Cailynoo7/makit-project-4/product/README.md

# 收音机外型静音漏接提醒器

面向中老年人的随身蓝牙挂件，由子女协助首次设置。优先支持 Android，降低手机静音或勿扰造成连续漏接的重要电话风险。

## 用户要求

保持低功耗蓝牙连接；10 分钟滑动窗口内连续 3 通来电均未接听，且处于静音/勿扰时触发。静音状态不可读时允许使用疑似静音模型。提示音可切换“叮咚叮咚”和“叮叮叮叮”，明显但不惊吓。查看手机、按前面单键停止提醒、接听或回拨后停止。22:00–06:00 默认无声。

后面是中心同高横排的Type-C充电口和ON/OFF开关机按键（电源键中心x7,z9），前面仅保留一个黑色底、红色三角标识的换音多功能键，位于原下方位置；上方圆形装饰略上移（默认1.5mm），顶部音量加减。严格参照上传图的黑色收音机外形，保留加粗圆角矩形提手，顶部正中设封闭半圆形穿绳孔、双圆网罩银色圈、长条调谐窗、中部方键与红色点缀。整体最长边不超过 60 mm。先完成硬件选择，再设计外壳。

## 手机侧可行性与待决事项

用户已选择轻量 Android 配套 App，由子女安装并首次授权，老人日常只使用挂件。应用负责电话状态、通知及铃声/勿扰状态读取、事件判定和 BLE 指令；挂件负责声音、按键、时间静音与连接状态。Android 伴侣设备授权不能替代电话/通知权限。

来电 RINGING→IDLE 不能独自区分未接与主动拒接；通知可能合并、多卡/来电等待可能造成歧义，不能将一条通知更新计作一通电话。默认结合电话状态与系统未接通知去重，不能辨认时不假装已确认。通知删除也不必然代表用户查看。实机未测试，不承诺跨品牌兼容。

## 平台候选与下游任务

主控默认选用 Seeed Studio XIAO nRF52840 Series（索引 seeed/xiao-ble，基础版，非 Sense/Plus）。厂商资料给出 21 × 17.8 mm、BLE 与 BQ25101 充电管理，适合小型低功耗挂件。选择理由为体积较小，厂商针对 BLE/低功耗提供支持，适合连续连接挂件；连接功耗仍须实测。

比较候选 M5Stack Atom Voice（m5stack/atomecho）：集成扬声器、24 × 24 × 16.8 mm，但较厚；厂商提供的 A2DP 示例不支持电话，本身不解决来电状态读取。Grove Speaker/Plus（seeed/grove-speaker、seeed/grove-speaker-plus）已检索，发声模块尺寸、电源和布置待核对。候选不构成采购清单或已验证装配。

硬件阶段由设计助手落实电池、音频驱动/扬声器、按键及供电，取得机械包络、充电口与装配证据后完成接线及零件清单。用户已选择设计小载板整理四个按键及音频、电源外围，保留 XIAO 主控，并接受制板费用与等待。CAD 在硬件和接线具备依据后开始。软件实施与实机兼容测试另需手机与固件开发环境，本文及外壳交付不代表功能样机已运行。

## 已披露默认值

- 60 mm 包含提手、按键和固定挂点，可拆挂绳除外；已按硬件定为总厚度目标约19mm，包含按键与固定突出部。单张参考图没有背面尺寸，背部按功能工程设计。
- 首版仅系统蜂窝来电，跨号码计数，接听成功或确认清空序列；拒接不计入疑似漏接。按第 3 通结束未接判定。
- 无法读取静音时，以连续未接且无成功接听/确认为启发式；不得宣称可证明静音。
- 前面原下方位置的三角标识单键：待机短按换音并试听，提醒中短按只停止本轮并清零，长按3秒开放60秒配对；后键长按 2 秒开关机。调谐窗为装饰，双网罩可由单扬声器出声。
- 仅解锁/亮屏不等于看过未接电话；点击未接通知或明确确认可作为查看证据，不能检测时在提醒中短按前面单键停止本轮，不能据此认定已查看手机。
- 提示每 10 秒一次、渐强起音、单轮至多 2 分钟，之后保留无声状态。3 档音量，最大档目标为 0.5 米处 65–75 dBA，须试听及实测。
- 手机同步本地时间；无有效时间则保持无声提示需连接。夜间不出声，06:00 不集中补响。
- 连续连接待机目标 72 小时、每日 10 次短提示，容量和实际续航在硬件阶段落实并实测。
- 断连不判漏接、不补报旧电话；重连去重。低电、断连用低亮状态灯提示。首版本地处理，不上传通话记录，BLE 不传号码。

## 验收

用时间戳序列验证 600 秒内第三通未接后触发，两通不触发、超窗不触发、接听后重计、拒接不误计、通知更新不重复。验证普通响铃时不误响，状态不可读走明确标注的疑似路径。验证两种提示音、三级音量、提醒中前面单键停止、已查看/接听/回拨停止，以及 22:00、06:00 边界、重启无时钟和断连重连。检查背部/前部/顶部操作位置；参考图可见元素保留；所有固定突出部在 60 mm 包络内。依据厂商机械资料检查硬件装配、充电插头空间及发声通道，最终交付 STEP。功能与功耗须样机测量，当前交付硬件设计与外壳模型，Android App及固件交付为待真机联调的软件验证版。

## 研究依据

- Android 来电状态监听：https://developer.android.com/reference/android/telephony/TelephonyCallback.CallStateListener
- Android 通知读取及勿扰状态：https://developer.android.com/reference/android/service/notification/NotificationListenerService
- 铃声模式：https://developer.android.com/reference/android/media/AudioManager#getRingerMode()
- Android 未接通知分类：https://developer.android.com/reference/android/app/Notification#CATEGORY_MISSED_CALL
- BLE 后台通信：https://developer.android.com/develop/connectivity/bluetooth/ble/background
- 伴侣配对仍需应用建立连接：https://developer.android.com/develop/connectivity/bluetooth/companion-device-pairing
- XIAO 厂商文档：https://wiki.seeedstudio.com/XIAO_BLE/
- Atom Voice 厂商文档：https://docs.m5stack.com/en/atom/atomecho

## 小载板与电池选择

用户选择小载板替代四键及外围手工飞线，授权载板设计；尚未制作电路板。主控仍是XIAO nRF52840。用户允许目录外电池，要求国内淘宝等平台可购买。

两个不同厂家候选有国内立创商城现货记录：

- 远阳 FLY.502728.390，C5154896，390 mAh。规格书第12页带PCM成品最大30.5×28×5.3 mm，线长33±5 mm；第5页充电4.2 V、标准78 mA、最大390 mA、最大放电390 mA、放电截止3.0 V。第4页裸电芯不能替代第12页成品。https://item.szlcsc.com/5783013.html ，2026-11-09查询11件。用户已选择；容量较大、较薄但较宽。
- 康胜 602030-300mAh-3.7V，C3036734，300 mAh。规格书第4页明确带PCM出线成品，最大33×20.5×6.5 mm，线长40±5 mm；第5页标准60 mA充电、4.2 V、连续放电300 mA、充电10–45℃。最大充电电流栏为空，不自行视为允许更高电流。https://item.szlcsc.com/3588019.html ，2026-11-09查询26件。较窄但较厚。

规格书已下载并检查机械图。保护板过流阈值不是电芯允许工作电流，额定容量不能直接承诺72小时待机。候选库存为公开查询快照。

另比较VCELL VP402030，200 mAh，带保护尺寸最大32.5×20.5×4.2 mm，4.2 V充电，标准40 mA、最大200 mA。厂商仅提供询价入口，未核实零售现货，故不优先：https://www.vcellpower-battery.com/zh_cn/3.7v/3-7v-200mah-402030-small-rechargeable-lipo-battery.html 。台思科402030-200mah C19632335在立创查询无现货。淘宝通用402030存在检索线索，但没有与上述精确厂家/带保护版本对应的直接证据，不承诺淘宝同型号现货。

用户已选远阳FLY.502728.390带PCM成品；康胜仅作机械不兼容的备选，不能直接换型。发声选用PAM8302AASCR及华龙HDK-1804AA-1W（18 mm、4Ω、额定0.8 W），已检查功放应用电路与扬声器机械图，音量未实测。前面多功能换音键及背面电源键选TS-1187A-B-A-B共2颗，顶部两键采用用户授权改选的侧按SHOU HAN TS24CA（C393942）。Grove Speaker要求4.0–5.5 V，不能直接覆盖单节锂电整个电压范围，未采用。设计助手在电池选定后落实充电、电源、连接及布局，再进行PCB与CAD。

载板规格52×26×1mm双层，采用供应商精确封装。外壳保持参考图提手、双圆网罩、银圈、调谐窗与中央方键/红点，整体目标60×48.4×约19mm。后盖2颗M2×6沉头螺钉可拆，前1、顶2、后1四键位置分面保持要求；默认PETG打样，薄装饰采用印刷/裁切薄膜。
## 薄型装配要求

整机总厚度约19mm，保留XIAO nRF52840基础版、390mAh带PCM电池、顶部音量键及后置Type-C。主控与电池在后部并排，前部扬声器及载板；默认取消高排针，改用低矮焊接短线。后置Type-C为载板垂直插座，连接XIAO的5V/GND，保留原板充电路径；只作充电，不提供后口USB数据。XIAO原USB保留在壳内，编程时拆盖。

外壳圆角适度加大，左右侧过渡连续对称；默认外轮廓四角R1.6mm、前缘R1.2mm、后缘R0.6mm。两侧内部加强条外缘内收0.35mm并遵循圆角轮廓，避免补出局部直边。

后盖要求外缘齐平、闭合贴合，避免明显大缝隙。默认内藏搭接与0.15mm接合面间隙，搭接方向侧向/轴向各留0.2mm装配余量；实际贴合需打印首件验证。

后盖固定采用左右对称沉头螺钉与内藏挂钩结构：下缘两个内藏挂钩，上缘保留2颗M2×6螺钉，拧紧后头部与后盖齐平，不加遮孔片，仅保留匹配沉头的小孔；整机厚度19.05mm，外缘齐平、名义细缝0.15mm，主控、电池、载板、四键及后置Type-C保持现有配置。

提手与前壳一体：默认条宽3.4mm、深3.6mm，外上角R2.0mm、内上角R1.4mm、前后边缘R0.45mm。中央圆拱内的半圆穿绳孔默认宽4mm、高2mm，用于细挂绳绳环；固定圆拱计入整机尺寸，总高约48.4mm，最长边仍60mm。穿绳与提手承载需首件验证。
