Cailynoo7/makit-project-4/design/radio-reminder/README.md

# 约19mm薄型收音机提醒器
中老年人随身挂件。保留黑色参考图收音机：60mm宽、48.4mm含提手/穿绳圆拱高，银色双圆圈与调谐窗、中央黑色方键、红色三角顶面和红点。整机含全部固定突出部60×48.4×19.05mm，机身60×34×17.5mm；约为厚版的一半。正面-Y、背面+Y、顶部+Z。顶部加减仍x=-18/-7，前面仅一个三角标识换音键，移至原下方中心x0,z-4；上方旧开口封闭，红色圆点中心z3.1mm（上移1.5mm），银色饰线保持，充电口和电源键在背面上部中心同高横排。默认PETG黑色、银灰饰圈，少量红和米色印刷装饰。

## 硬件与接口
hardware_fit：载板当前发布bbae20a434339443ea3c5a5be6bef92bbbb1d6c7cf2214563fcd01bb77dd2b27，真实装配STEP，52×26×1mm，Rxyz=(90,0,0)、T=(-100,-0.3,100)。取消高排针，10根30AWG约50mm绝缘短线贴板平铺，焊点/线层高度≤0.8mm。
XIAO基础版板面平行前后壳，长轴X，原USB朝+X留在壳内。官方v1.2 KiCad/DXF外轮廓20.955×17.78mm；PCB中心(15.4,5.8,-3.5)，基板保留1mm，元件向前保留4mm，原USB最大保留至x27.386。高度为工程保留区，非实物量测；无可用官方STEP，不发布假主控实体。
后口GT-USB-7096C为8.5±0.2mm垂直插座，载板B面，中心x17.4,z9；后盖外侧收口9.54×3.76mm、R1.6，内侧11.8×5.4mm胶囊让位。实际口沿y9.135，突出壳面约0.385mm，整机最大后边界仍由电源帽y9.45限定。5V/GND接XIAO原充电路径，两路CC各5.1k下拉；后口只充电。原USB供拆盖编程，不同时接两口电源。
电池为用户选定FLY.502728.390带PCM，最大30.5×28×5.3mm，中心(-10.8,3.6,0)，后面0.5mm可移除泡棉贴后盖。XIAO与电池并排，间距0.4725mm。
扬声器HDK-1804AA-1W最大D18.2×4.8mm，中心(-18,-3.95,-5)，轴沿Y；左罩出声、右罩盲孔装饰。前加0.15mm黑色透声布；边缘胶固定。扬声器、电池和XIAO用临时最大包络查询，不以占位块冒充真实零件。
user_controls：前1顶2后1，顶部TS24CA C393942。换音单键中心x0,z-4；无独立确认键；音量加减x-18/-7、y-1.95；后电源x7,z9，与Type-C同高。radio_reference为用户原图。

## 检查
所有单独制造件均一实体；各已发布对象无共享实体体积。总包络X[-30,30]、Y[-9.6,9.45]、Z[-17,31.4]mm。
0.02mm网格：载板对壳最小0.155mm；电池对前壳0.25mm、对下挂钩0.2mm、对载板0.318mm；XIAO板对后盖0.2mm，元件保留区对载板0.21mm；原USB对侧壳0.214mm；扬声器最大包络对壳0.1916mm、对载板0.3mm。只是设计间隙，不是打印后实测公差。
先卸两颗齐平沉头螺钉；后盖/电源帽绕下缘(0,6.6,-17)沿X轴向后转7°，上移0.8mm，再后退20mm脱钩。0.1mm步长、0.02mm网格、265姿态对前壳/载板检查无穿插；线束、贴后盖的主控/电池维修余量需实装复核。
保留四键的0.3mm压下路径；单个前键已以0.1mm步长复核，旧顶键和后键几何保持，以0.1mm步长、0.02mm网格检查不撞壳；最小顶部0.1mm、正面0.25mm，电源按到底余0.05mm。该0.05mm为轴向止挡余量，头部径向滑动间隙0.25mm；首件应检查回弹并调整打印补偿。开关模型静止端与推杆约0.15mm间隙。

## Making and assembly
默认PETG、0.2mm喷嘴、0.1mm层高，至少4壁。正面壁2mm、侧/顶壁2.4mm；前壳面朝下，提手背面及内部悬臂有可拆支撑，功能滑道和螺钉孔避免残留。后盖外侧朝下、定位边朝上，支撑内部短悬臂；四键帽、银圈、调谐框/底片独立打印。可改韧性树脂打样，但先试拧螺钉、不强拧。
后盖由套件生成的2颗ISO7046 M2-0.4×6沉头螺钉连接、4mm自成形啮合，改为左右对称位置(-27.4,8.75,13.8)、(27.4,8.75,13.8)。套件采用boss=none，利用原侧壁局部加厚条锚固，不增加凸出的螺钉柱；不强拧。螺钉座使用90°沉头、head_recess=0，采用名义齐平沉头，套件的打印补偿使模型头顶低于盖面0.1mm，避免凸出，首件按真实螺钉试配齐平；删除遮孔片和Φ4.9大圆槽，仅保留套件按M2沉头头径生成的约Φ4.21mm沉孔。下缘x±18mm各有5mm宽、0.8mm厚刚性挂钩，先斜插再合盖，不依赖强行弹性卡入。后盖外缘与前壳同宽同高齐平；接合面各0.1mm去锐，名义接合面间隙0.15mm。侧壁及上缘内藏搭接从前壳末端伸出0.85mm、截面1.6mm，侧向及轴向各留0.2mm；Z<-10mm区域去掉搭接以便斜开，底边由挂钩压住。螺钉区让位，保持完整沉头承压区；搭接位于原侧壁厚度内，不侵入电池或原USB空间。调谐框用套件生成胶垫连接；银圈浅槽点柔性中性电子胶。U饰线、红点、红调谐线和2片米色表盘为印刷/裁切薄膜，不做FDM结构件。
先从内侧装前/顶部帽，再后装载板。定位轨前挡两边点胶，下缘后挡3×1mm、厚0.3mm泡棉。检查PCB平整、前按键无预压。XIAO元件面朝前，后面通过2条3×10mm、厚0.25mm薄胶贴在后盖固定面，并由下缘定位边定位。电池用2条0.5mm泡棉贴后盖内面，不加硬夹、不能压迫电芯。
按载板说明逐根焊接10线，保留约50mm长度及维修松弛量；余线在载板背面空区绝缘平铺，控制线层≤0.8mm，不在电池/主控之间叠成线团，不加金属胶带覆盖天线。电池TP1+/TP2-、扬声器TP3/TP4，BTL两端均不可接地。原线不足时用28AWG柔软线延长并热缩绝缘、胶点卸力。
电源帽从后盖内侧穿入，检查凸缘与导向孔滑动；新短推杆替代原长杆。合盖前先逐键确认回弹、Type-C居中及细壳插头可完全插入，先斜插下挂钩后压合上缘，再交替轻拧两颗螺钉至贴合。

## 首件验证边界
载板制作包已通过电气/间距及连通检查，另有4条非阻断丝印提示。外壳是计算装配检查通过的打样设计；需首件量测XIAO真实高度、按帽行程/回弹、线层、Type-C、拆盖余量和提手承载。XIAO天线邻近电池及载板，BLE范围和连接功耗需首样验证；不把装得下当作射频通过。App与固件为已编译、待真机联调的软件验证版；静音漏接、夜间、响度、续航、充电终止/温升和EMC未实测。XIAO充电TS为固定电阻，无电池实时测温。

后盖配合首件：去掉搭接槽与端面毛刺，先不放电子件轻压合盖，验证0.15mm接合间隙均匀、无翘曲，再装电子件。打印配合偏紧时先调整隐藏搭接侧隙，不强拧螺钉拉平。保留细缝供拆装，不宣称零缝或防水。前壳/后盖均为60×34mm外轮廓；0.02mm网格、0.1mm步长的后盖7°倾斜、0.8mm上提、20mm退出检查无穿插，单件各一实体，整机仍60×48.4×19.05mm。

隐藏固定首件：检查两个挂钩根部及边缘无支撑残留，验证螺钉顶面齐平；螺钉孔附近侧壁余肉约1mm，先验证低扭矩锁紧与反复拆装，挂钩保持力和跌落实测未完成。后盖两颗M2×6改为露出且齐平的沉头固定，下面仍为内藏挂钩；正面改为单键，载板已删除独立确认开关。

## 正面单键布局与功能
正面只保留原下方位置的方形三角标识换音键；删除圆形标识确认键和原上方开口，前壳恢复连续表面。键帽黑色，三角凸纹顶面红色，与红点同色调；键帽6.2mm、孔边每侧0.25mm间隙，按帽推杆对准载板SW_SOUND中心(0,-4)。待机短按换音试听，提醒中短按只停止本轮并清空计数，不记录为已查看手机；长按3秒开放60秒配对。载板删SW_ACK、TP8、ACK网络及XIAO D3线，连接改为10线。四键其余分布与19.05mm总厚度、0.15mm接缝及隐藏后盖固定保持。

## 背面布局
电源键上移到x7,z9，与Type-C中心z9对齐，保持原键帽、同一开关及D6功能。下方居中推杆会穿入电池最大包络，因而采用上方横排。两颗黑色M2×6采用名义齐平沉头，模型头顶低于盖面0.1mm，不增加遮孔片，不再挖独立大圆槽；名义接缝0.15mm和整体厚度19.05mm保持。

## 后口轮廓
采用内侧让位、外侧贴合收口的台阶结构。真实插座口沿位于y8.285附近，外轮廓约9.14×3.36mm；可见孔9.54×3.76mm、角R1.6，名义每边0.2mm余量。收口边y8.45至9.15，轴向0.7mm，高出背板0.4mm；与后盖一体，外边12.2×5.8mm胶囊，与主盖重叠连接。深处保留11.8×5.4mm胶囊孔清让插座本体。收口环对真实载板局部最小净距约0.2592mm，非零间隙配合；整机后界仍由电源帽y9.45限定。
收口边为精细非承力特征，保持0.2mm喷嘴、0.1mm层高；外表面有0.4mm凸起后，不能再将外侧平面直接贴打印床。后盖须外侧朝上，内侧凸台/挂钩用可拆支撑，或采用韧性树脂首件。支撑不得残留在接口孔、搭接及螺钉座。须实测插头肩部不顶收口、能完全插入及充电；名义每边0.2mm间隙需要打印校准，不承诺零缝或所有线缆兼容。

## 前面配色与圆点位置
三角标识使用红色#c22b43，基底黑色#202124。三角仍为键帽原有凸纹，顶面名义0.05mm为红色丙烯酸涂层，替代同体积黑色材料，总凸起高度0.25mm保持。模型中的sound_triangle为涂装区域，不是另一个按键或需要单独装配的零件；单色打印黑色键帽后以细笔给凸纹顶面上红色，固化后检查不蹭色，避免漆进入导向间隙。不要把0.05mm涂层单独作为FDM打印件。
上方圆形装饰仍直径2.9mm、中心x0，中心z由1.6mm上移至3.1mm。1.5mm为默认上移量，可通过圆点中心高度参数调整；没有新增前壳开孔或电气器件。

## 提手与挂绳孔
提手与前壳一体，保留58mm外宽和主框10mm出高；横梁、两侧的名义条宽均3.4mm，前后深3.6mm。外上角R2mm、内上角R1.4mm，前后轮廓边缘R0.45mm，减少原先薄直梁的生硬感。顶部中央有半圆外形的整体圆拱（外半径4.4mm），根部R0.6mm过渡；圆拱内为封闭D形半圆穿绳孔，名义宽4mm、高2mm，平底z27.2、轴沿前后Y。孔口前后也R0.45mm去锐，避免尖锐孔沿磨绳。
圆拱顶z31.4mm，整机总高48.4mm，最长边仍60mm，总厚度19.05mm。孔圈承力中段顶部名义厚度约2.2mm，前后圆角后的孔口薄缘需首件复核，须首件检查实际壁厚、打印层间完整性及挂绳反复拉扯；不宣称通过承载或跌落测试。适配细软绳环，不默认金属钥匙圈或粗编织绳均可穿过。保持PETG至少4壁，提手及圆拱整体打印；孔内支撑和毛刺需彻底去除。

穿绳孔空间检查：两股直径1.2mm、中心x±0.75mm/z28.05mm的直线绳段沿Y贯穿查询，与壳体无穿插；半圆孔位不变，圆拱加厚只向孔外扩展。0.02mm网格下原轮廓查询最小间隙0.25mm；仅验证几何穿过，不代表实际软绳摩擦/打结或承载已验证。

## 外壳圆角与侧边连续性
前后壳共用外轮廓四角R1.6mm，前面外缘R1.2mm、后盖外缘R0.6mm；接合边R0.1mm及名义0.15mm接缝保持。左右内部螺钉加强条外缘内收0.35mm，并按相同R1.6外轮廓裁切，避免加强条补平外圆角、在左右侧形成不连续直边。加强条原内边界保持，硬件位置不变。
本版解析几何检查：加强条区域超出共用圆角轮廓的体积为0，左右外侧接缝突起探针体积均为0，前壳为单一实体。左右侧视及前后斜视复核过渡连续。后盖/电源帽按7°倾斜、0.8mm上提、20mm退出路径复核无穿插，步长0.1mm、网格公差0.02mm、265姿态。外形60×48.4×19.05mm保持；打印后的接缝均匀度、沉头强度及拆装仍需首件验证。
