Cailynoo7/makit-project-4/manufacturing/reminder-carrier/releases/bbae20a434339443ea3c5a5be6bef92bbbb1d6c7cf2214563fcd01bb77dd2b27/package/drill/reminder-carrier-drill-report.txt

Drill report for board.kicad_pcb
Created on 2026-11-09T09:46:59

Copper Layer Stackup:
    =============================================================
    L1 :  F.Cu                      front
    L2 :  B.Cu                      back

Drill file 'board-PTH.drl' contains
    plated through holes:
    =============================================================
    T1  0.300mm  0.0118"  (7 holes))
    T2  0.800mm  0.0315"  (4 holes)  (with 4 slots)
    T3  1.000mm  0.0394"  (12 holes))

    Total plated holes count 23

Drill file 'board-NPTH.drl' contains
    unplated through holes:
    =============================================================
    T1  0.600mm  0.0236"  (2 holes))
    T2  0.700mm  0.0276"  (4 holes))

    Total unplated holes count 6
