Cailynoo7/makit-project-4/product/gallery/cover.jpg

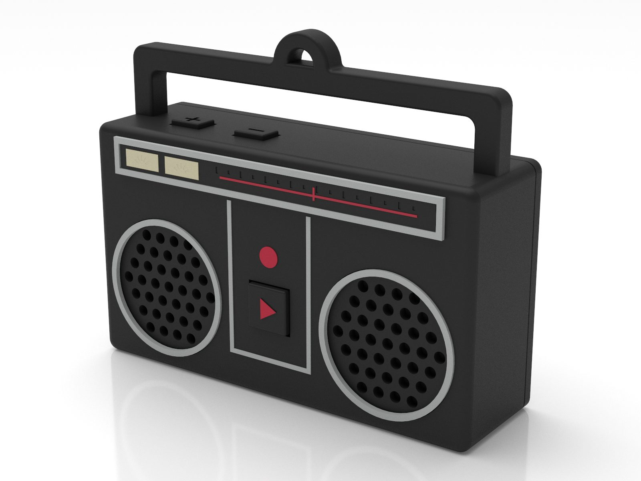
product/gallery/cover.jpg
