Cailynoo7/makit-project-4/product/bom.csv

id | name | quantity | manufacturer | part_number | lcsc_code | platform_ref | source | product_url | datasheet_url | image_url
main_controller | Seeed Studio XIAO nRF52840 Series | 1 | Seeed Studio | XIAO nRF52840 |  | seeed/xiao-ble | default |  | https://wiki.seeedstudio.com/XIAO_BLE/
audio_amplifier | PAM8302AASCR | 1 | DIODES(美台) | PAM8302AASCR | C113367 |  | research | https://item.szlcsc.com/114602.html | https://atta.szlcsc.com//upload/public/pdf/source/20230810/52852F39DA29CF93A1E8F68F81017496.pdf | https://alimg.szlcsc.com/upload/public/product/source/20250911/7007FCD8F8CA9F35A08A62187AF9166F.jpg
speaker | HDK-1804AA-1W | 1 | Dragonstate(华龙) | HDK-1804AA-1W | C18221550 |  | research | https://item.szlcsc.com/19402723.html | https://atta.szlcsc.com//upload/public/pdf/source/20231012/5599EDEB300A326DE981CF06FE959172.pdf | https://alimg.szlcsc.com/upload/public/product/source/20231023/D3906AA5DC241ACB368DB46003C14D7F.jpg
face_keys | TS-1187A-B-A-B | 2 | XKB Connection(中国星坤) | TS-1187A-B-A-B | C318884 |  | research | https://item.szlcsc.com/299976.html | https://atta.szlcsc.com//upload/public/pdf/source/20200227/C318890_053E50208A88A7BA1965D8746000774E.pdf | https://alimg.szlcsc.com/upload/public/product/source/20230108/88172F1E1FCBE40FF10527789D18E309.jpg
battery | FLY.502728.390 | 1 | FLYOUNG(远阳) | FLY.502728.390 | C5154896 |  | user | https://item.szlcsc.com/5783013.html | https://atta.szlcsc.com//upload/public/pdf/source/20220914/26DADB1697C2AEB7516680D8C536C975.pdf | https://alimg.szlcsc.com/upload/public/product/source/20230105/5BCDD7657F4DBDBD31D85CDD4DE336D1.jpg
volume_keys | TS24CA | 2 | SHOU HAN(首韩) | TS24CA | C393942 |  | default | https://item.szlcsc.com/372554.html | https://atta.szlcsc.com//upload/public/pdf/source/20250627/84CD38276554A1E56A2B8104F1C5161E.pdf | https://alimg.szlcsc.com/upload/public/product/source/20250824/9F3719C0BFD5A071020BD258ADA3305B.jpg
r10k | 0603WAF1002T5E | 5 | UNI-ROYAL(厚声) | 0603WAF1002T5E | C25804 |  | research | https://item.szlcsc.com/26547.html | https://atta.szlcsc.com//upload/public/pdf/source/20200306/C422600_1E6D84923E4A46A82E41ADD87F860B5C.pdf | https://alimg.szlcsc.com/upload/public/product/source/20250618/A8DD5FF53E8BE3A05CC533FBBE26BF71.jpg
r1k | 0603WAF1001T5E | 1 | UNI-ROYAL(厚声) | 0603WAF1001T5E | C21190 |  | research | https://item.szlcsc.com/21904.html | https://atta.szlcsc.com//upload/public/pdf/source/20200306/C422600_1E6D84923E4A46A82E41ADD87F860B5C.pdf | https://alimg.szlcsc.com/upload/public/product/source/20221228/6165AACA9F1A557BC3C736378F140C8D.jpg
c10n | 0603B103K500NT | 2 | FH(风华) | 0603B103K500NT | C57112 |  | research | https://item.szlcsc.com/58143.html | https://atta.szlcsc.com//upload/public/pdf/source/20260730/02F3503A6D76391150EDFB346112EFA5.pdf | https://alimg.szlcsc.com/upload/public/product/source/20251028/C55948F0328370812731751A4634B270.jpg
c100n | CC0603KRX7R9BB104 | 2 | YAGEO(国巨) | CC0603KRX7R9BB104 | C14663 |  | research | https://item.szlcsc.com/15331.html | https://atta.szlcsc.com//upload/public/pdf/source/20250214/096C4C206003071F5D32E5F0D8E7F8DF.pdf | https://alimg.szlcsc.com/upload/public/product/source/20250715/565F44E7FCAE51D13767AECBC328360D.jpg
c1u | CL10A105KB8NNNC | 1 | SAMSUNG(三星) | CL10A105KB8NNNC | C15849 |  | research | https://item.szlcsc.com/16531.html | https://atta.szlcsc.com//upload/public/pdf/source/20160218/1457707763339.pdf | https://alimg.szlcsc.com/upload/public/product/source/20221228/5F5303D0D45633FD8A94BF04275D83DA.jpg
c10u | CL10A106KP8NNNC | 2 | SAMSUNG(三星) | CL10A106KP8NNNC | C19702 |  | research | https://item.szlcsc.com/20411.html | https://atta.szlcsc.com//upload/public/pdf/source/20160218/1457707763339.pdf | https://alimg.szlcsc.com/upload/public/product/source/20221228/9808C9BEFFFABB90D0C992860D83393B.jpg
carrier_pcb | 漏接提醒器载板 52×26×1mm FR4 双层 | 1 |  | reminder-carrier bare PCB |  |  | default
rear_fasteners | ISO 7046 M2-0.4×6mm 十字沉头螺钉 黑色 | 2 |  | ISO7046-M2x6-black |  |  | default
printed_enclosure | 约19mm薄型收音机外壳PETG套装：加粗圆角提手与中央半圆穿绳孔、内藏挂钩与齐平沉头固定前壳/后盖、4键帽、2饰圈、调谐框与底片 | 1 |  | radio-reminder-print-set |  |  | default
decorative_films | 银色U形饰线、红点、红调谐线、2片米色电平表薄膜套装；按模型裁切 | 1 |  | radio-reminder-decal-set |  |  | default
speaker_mesh | 黑色透声布圆片 直径18.4mm 厚0.15mm | 1 |  | acoustic-cloth-18.4x0.15 |  |  | default
battery_adhesive | 可移除双面泡棉胶 厚0.5mm 3×22mm，电池贴后盖内面 | 2 |  | removable-foam-0.5-3x22 |  |  | default
pcb_retention_pads | 泡棉胶垫 厚0.3mm 3×1mm，用于载板下缘后挡 | 1 |  | foam-0.3-3x1 |  |  | default
xiao_retention_tape | 可移除双面薄胶 厚0.25mm 3×10mm，XIAO后固定面 | 2 |  | removable-tape-0.25-3x10 |  |  | default
internal_wire | 28AWG柔软绝缘线 红黑各50mm两组，用于电池及扬声器延长，接头热缩绝缘 | 2 |  | 28AWG-red-black-50mm-pair |  |  | default
adhesive | 柔性中性电子胶 小包装，用于扬声器边框、饰圈和调谐框，勿涂振膜 | 1 |  | neutral-electronics-adhesive |  |  | default
lanyard | 可拆细挂绳 绳环单股直径≤1.2mm，穿提手顶部半圆孔 | 1 |  | detachable-lanyard-1.5mm |  |  | default
charge_cable | USB Type-C充电线，5V电源；后口仅充电，外侧收口9.54×3.76mm、R1.6；内侧11.8×5.4mm胶囊让位 | 1 |  | USB-C-compact-charge-cable |  |  | default
controller_solder_wires | 30AWG柔软绝缘焊接线 50mm 10根及热缩管，贴板布线高度≤0.8mm，余线平铺留维修余量 | 1 |  | 30AWG-50mm-10-wire-set |  |  | default
charge_usb | GT-USB-7096C | 1 | G-Switch | GT-USB-7096C | C19188081 |  | default | https://www.lcsc.com/product-detail/C19188081.html | https://datasheet.lcsc.com/datasheet/pdf/a5fd5605f60cbc21c64083528ce14d6d.pdf
usb_cc_resistors | 0603WAF5101T5E | 2 | UNI-ROYAL(厚声) | 0603WAF5101T5E | C23186 |  | default | https://www.lcsc.com/product-detail/C23186.html | https://atta.szlcsc.com//upload/public/pdf/source/20200306/C422600_1E6D84923E4A46A82E41ADD87F860B5C.pdf
red_marking_paint | 水性丙烯酸模型漆 红色 小包装，用于黑色键帽三角凸纹顶面 | 1 |  | red-acrylic-marking-paint |  |  | default
