Cailynoo7/makit-project-4/product/software-validation/v0.4.0/Android兼容性测试记录.csv

品牌 | 型号 | Android版本_API | 厂商系统_构建号 | 国行或海外ROM | 安装来源 | App版本 | 通话记录可读 | 通知兼容模式 | 后台设置摘要 | 场景ID | 轮次 | 手机充电状态 | 外部拨入时间 | 首次保存时间 | 历史检测来源 | 最近自动启动来源与时间 | 是否先手动打开App | 挂件连接与时间状态 | 实际发声时间 | 恢复或提醒延迟秒 | 结果 | 备注
Google Pixel |  |  |  |  |  | 0.4.0-validation |  |  |  | C01 |  |  |  |  |  |  |  |  |  |  | 待测 | 占位，尚无对应真机验证；每台实际手机与每轮应另建记录
Google Pixel |  |  |  |  |  | 0.4.0-validation |  |  |  | C02 |  |  |  |  |  |  |  |  |  |  | 待测 | 占位，尚无对应真机验证；每台实际手机与每轮应另建记录
Google Pixel |  |  |  |  |  | 0.4.0-validation |  |  |  | C03 |  |  |  |  |  |  |  |  |  |  | 待测 | 占位，尚无对应真机验证；每台实际手机与每轮应另建记录
Google Pixel |  |  |  |  |  | 0.4.0-validation |  |  |  | C04 |  |  |  |  |  |  |  |  |  |  | 待测 | 占位，尚无对应真机验证；每台实际手机与每轮应另建记录
Google Pixel |  |  |  |  |  | 0.4.0-validation |  |  |  | C05 |  |  |  |  |  |  |  |  |  |  | 待测 | 占位，尚无对应真机验证；每台实际手机与每轮应另建记录
Google Pixel |  |  |  |  |  | 0.4.0-validation |  |  |  | C06 |  |  |  |  |  |  |  |  |  |  | 待测 | 占位，尚无对应真机验证；每台实际手机与每轮应另建记录
Google Pixel |  |  |  |  |  | 0.4.0-validation |  |  |  | C09 |  |  |  |  |  |  |  |  |  |  | 待测 | 占位，尚无对应真机验证；每台实际手机与每轮应另建记录
Google Pixel |  |  |  |  |  | 0.4.0-validation |  |  |  | C11 |  |  |  |  |  |  |  |  |  |  | 待测 | 占位，尚无对应真机验证；每台实际手机与每轮应另建记录
Google Pixel |  |  |  |  |  | 0.4.0-validation |  |  |  | C14 |  |  |  |  |  |  |  |  |  |  | 待测 | 占位，尚无对应真机验证；每台实际手机与每轮应另建记录
三星 |  |  |  |  |  | 0.4.0-validation |  |  |  | C01 |  |  |  |  |  |  |  |  |  |  | 待测 | 占位，尚无对应真机验证；每台实际手机与每轮应另建记录
三星 |  |  |  |  |  | 0.4.0-validation |  |  |  | C02 |  |  |  |  |  |  |  |  |  |  | 待测 | 占位，尚无对应真机验证；每台实际手机与每轮应另建记录
三星 |  |  |  |  |  | 0.4.0-validation |  |  |  | C03 |  |  |  |  |  |  |  |  |  |  | 待测 | 占位，尚无对应真机验证；每台实际手机与每轮应另建记录
三星 |  |  |  |  |  | 0.4.0-validation |  |  |  | C04 |  |  |  |  |  |  |  |  |  |  | 待测 | 占位，尚无对应真机验证；每台实际手机与每轮应另建记录
三星 |  |  |  |  |  | 0.4.0-validation |  |  |  | C05 |  |  |  |  |  |  |  |  |  |  | 待测 | 占位，尚无对应真机验证；每台实际手机与每轮应另建记录
三星 |  |  |  |  |  | 0.4.0-validation |  |  |  | C06 |  |  |  |  |  |  |  |  |  |  | 待测 | 占位，尚无对应真机验证；每台实际手机与每轮应另建记录
三星 |  |  |  |  |  | 0.4.0-validation |  |  |  | C09 |  |  |  |  |  |  |  |  |  |  | 待测 | 占位，尚无对应真机验证；每台实际手机与每轮应另建记录
三星 |  |  |  |  |  | 0.4.0-validation |  |  |  | C11 |  |  |  |  |  |  |  |  |  |  | 待测 | 占位，尚无对应真机验证；每台实际手机与每轮应另建记录
三星 |  |  |  |  |  | 0.4.0-validation |  |  |  | C14 |  |  |  |  |  |  |  |  |  |  | 待测 | 占位，尚无对应真机验证；每台实际手机与每轮应另建记录
vivo_iQOO |  |  |  |  |  | 0.4.0-validation |  |  |  | C01 |  |  |  |  |  |  |  |  |  |  | 待测 | 占位，尚无对应真机验证；每台实际手机与每轮应另建记录
vivo_iQOO |  |  |  |  |  | 0.4.0-validation |  |  |  | C02 |  |  |  |  |  |  |  |  |  |  | 待测 | 占位，尚无对应真机验证；每台实际手机与每轮应另建记录
vivo_iQOO |  |  |  |  |  | 0.4.0-validation |  |  |  | C03 |  |  |  |  |  |  |  |  |  |  | 待测 | 占位，尚无对应真机验证；每台实际手机与每轮应另建记录
vivo_iQOO |  |  |  |  |  | 0.4.0-validation |  |  |  | C04 |  |  |  |  |  |  |  |  |  |  | 待测 | 占位，尚无对应真机验证；每台实际手机与每轮应另建记录
vivo_iQOO |  |  |  |  |  | 0.4.0-validation |  |  |  | C05 |  |  |  |  |  |  |  |  |  |  | 待测 | 占位，尚无对应真机验证；每台实际手机与每轮应另建记录
vivo_iQOO |  |  |  |  |  | 0.4.0-validation |  |  |  | C06 |  |  |  |  |  |  |  |  |  |  | 待测 | 占位，尚无对应真机验证；每台实际手机与每轮应另建记录
vivo_iQOO |  |  |  |  |  | 0.4.0-validation |  |  |  | C09 |  |  |  |  |  |  |  |  |  |  | 待测 | 占位，尚无对应真机验证；每台实际手机与每轮应另建记录
vivo_iQOO |  |  |  |  |  | 0.4.0-validation |  |  |  | C11 |  |  |  |  |  |  |  |  |  |  | 待测 | 占位，尚无对应真机验证；每台实际手机与每轮应另建记录
vivo_iQOO |  |  |  |  |  | 0.4.0-validation |  |  |  | C14 |  |  |  |  |  |  |  |  |  |  | 待测 | 占位，尚无对应真机验证；每台实际手机与每轮应另建记录
OPPO |  |  |  |  |  | 0.4.0-validation |  |  |  | C01 |  |  |  |  |  |  |  |  |  |  | 待测 | 占位，尚无对应真机验证；每台实际手机与每轮应另建记录
OPPO |  |  |  |  |  | 0.4.0-validation |  |  |  | C02 |  |  |  |  |  |  |  |  |  |  | 待测 | 占位，尚无对应真机验证；每台实际手机与每轮应另建记录
OPPO |  |  |  |  |  | 0.4.0-validation |  |  |  | C03 |  |  |  |  |  |  |  |  |  |  | 待测 | 占位，尚无对应真机验证；每台实际手机与每轮应另建记录
OPPO |  |  |  |  |  | 0.4.0-validation |  |  |  | C04 |  |  |  |  |  |  |  |  |  |  | 待测 | 占位，尚无对应真机验证；每台实际手机与每轮应另建记录
OPPO |  |  |  |  |  | 0.4.0-validation |  |  |  | C05 |  |  |  |  |  |  |  |  |  |  | 待测 | 占位，尚无对应真机验证；每台实际手机与每轮应另建记录
OPPO |  |  |  |  |  | 0.4.0-validation |  |  |  | C06 |  |  |  |  |  |  |  |  |  |  | 待测 | 占位，尚无对应真机验证；每台实际手机与每轮应另建记录
OPPO |  |  |  |  |  | 0.4.0-validation |  |  |  | C09 |  |  |  |  |  |  |  |  |  |  | 待测 | 占位，尚无对应真机验证；每台实际手机与每轮应另建记录
OPPO |  |  |  |  |  | 0.4.0-validation |  |  |  | C11 |  |  |  |  |  |  |  |  |  |  | 待测 | 占位，尚无对应真机验证；每台实际手机与每轮应另建记录
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
华为Android兼容系统 |  |  |  |  |  | 0.4.0-validation |  |  |  | C11 |  |  |  |  |  |  |  |  |  |  | 待测 | 占位，尚无对应真机验证；每台实际手机与每轮应另建记录
华为Android兼容系统 |  |  |  |  |  | 0.4.0-validation |  |  |  | C14 |  |  |  |  |  |  |  |  |  |  | 待测 | 占位，尚无对应真机验证；每台实际手机与每轮应另建记录
