Cailynoo7/makit-project-4/manufacturing/reminder-carrier/releases/bbae20a434339443ea3c5a5be6bef92bbbb1d6c7cf2214563fcd01bb77dd2b27/package/assembly.step

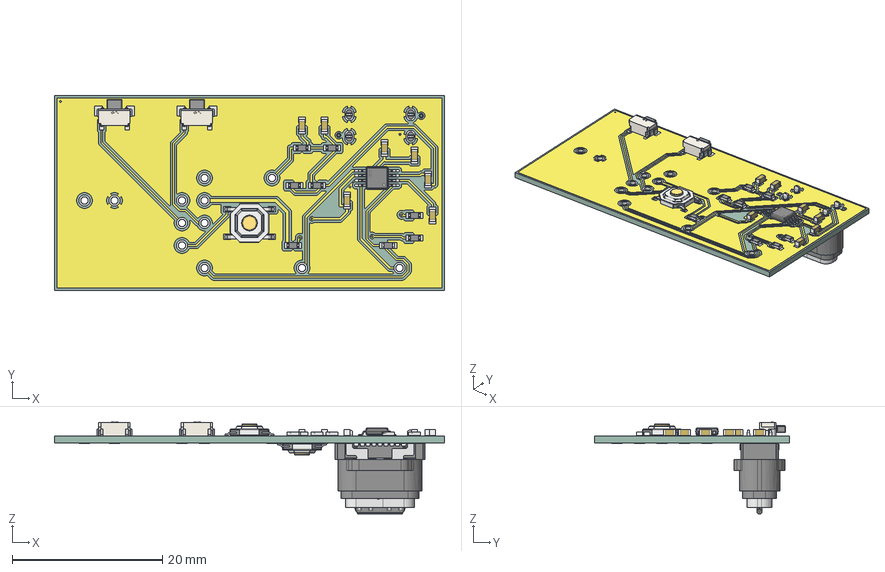
[picture p2: CAD file, 2026-11-09]
manufacturing/reminder-carrier/releases/bbae20a434339443ea3c5a5be6bef92bbbb1d6c7cf2214563fcd01bb77dd2b27/package/assembly.step
52.0 x 26.0 x 12.2 mm
C0603_L1.6-W0.8-H0.8 x 7
MSOP-8_L3.0-W3.0-P0.65-LS5.0-BL
SW-SMD_2P-TS24CA x 2
R0603 x 8
SW-SMD_4P-L5.1-W5.1-P3.70-LS6.5-TL_H1.5 x 2
USB-TYPE-C-SMD_GT-USB-7096C
board_copper
board_pad
board_via
board_PCB
