Cailynoo7/makit-project-4/manufacturing/radio-reminder/releases/export-cbfe1a81d10e49270eff96f118f5473d/model.step

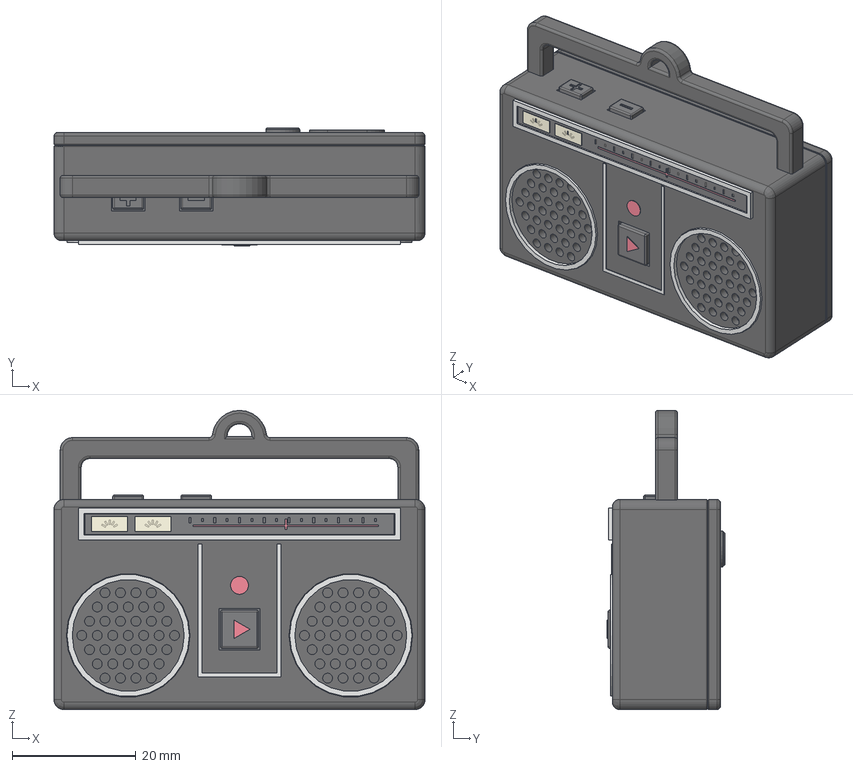
[picture p3: CAD file, 2026-11-10]
manufacturing/radio-reminder/releases/export-cbfe1a81d10e49270eff96f118f5473d/model.step
60.0 x 19.1 x 48.4 mm
front_shell
C0603_L1_6-W0_8-H0_8 x 7
MSOP-8_L3_0-W3_0-P0_65-LS5_0-BL
board_PCB
rear_lid
tuner_panel
sound_key
volume_up
volume_down
power_key
dial_red
