Cailynoo7/makit-project-4/design/radio-reminder/source/assets/fcab3e22e1e0827fe7b8ea0bb716072b5507669853ad1d7223d066955ea6e433.step

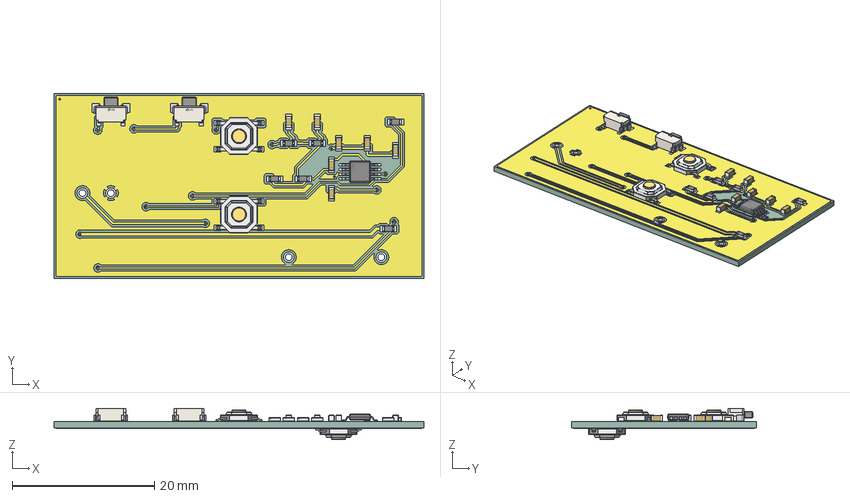
[picture p4: CAD file, 2026-11-10]
design/radio-reminder/source/assets/fcab3e22e1e0827fe7b8ea0bb716072b5507669853ad1d7223d066955ea6e433.step
52.0 x 26.0 x 4.40 mm
C0603_L1.6-W0.8-H0.8 x 7
R0603 x 6
SW-SMD_2P-TS24CA x 2
SW-SMD_4P-L5.1-W5.1-P3.70-LS6.5-TL_H1.5 x 3
MSOP-8_L3.0-W3.0-P0.65-LS5.0-BL
board_copper
board_pad
board_via
board_PCB
