Cailynoo7/makit-project-4/design/radio-reminder/source/assets/69f0ab60741e9760c49b0969f4a014d4314382c1bede449fe0c420f43be73c0c.step

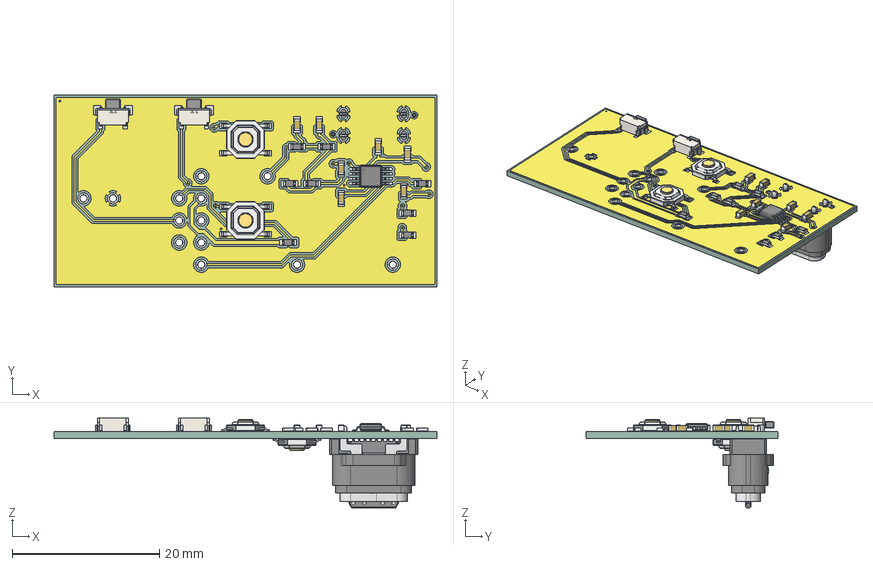
[picture p5: CAD file, 2026-11-10]
design/radio-reminder/source/assets/69f0ab60741e9760c49b0969f4a014d4314382c1bede449fe0c420f43be73c0c.step
52.0 x 26.0 x 12.2 mm
SW-SMD_2P-TS24CA x 2
C0603_L1.6-W0.8-H0.8 x 7
R0603 x 8
SW-SMD_4P-L5.1-W5.1-P3.70-LS6.5-TL_H1.5 x 3
MSOP-8_L3.0-W3.0-P0.65-LS5.0-BL
USB-TYPE-C-SMD_GT-USB-7096C
board_copper
board_pad
board_via
board_PCB
