Cailynoo7/makit-project-4/design/radio-reminder/source/assets/7c947fffd4b019435b5fcc80e51967e8a3ffbe3208249d547059c1004281f707.step

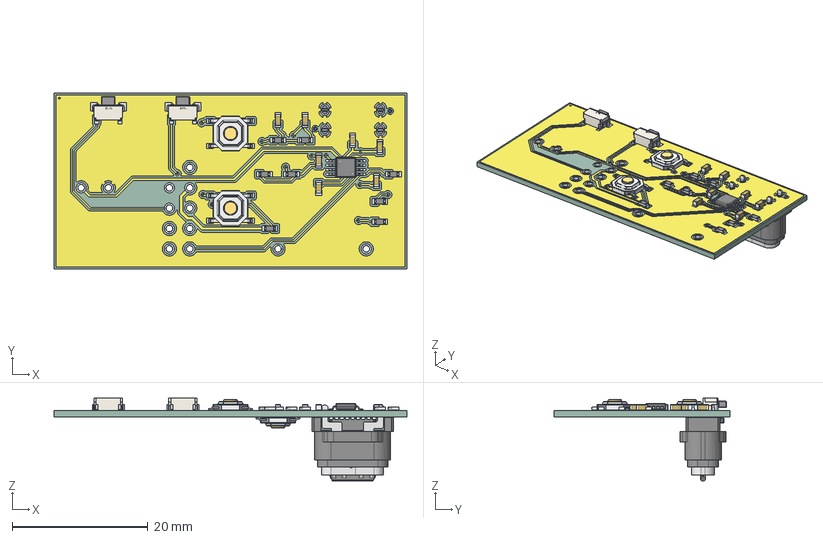
[picture p6: CAD file, 2026-11-10]
design/radio-reminder/source/assets/7c947fffd4b019435b5fcc80e51967e8a3ffbe3208249d547059c1004281f707.step
52.0 x 26.0 x 12.2 mm
R0603 x 8
SW-SMD_2P-TS24CA x 2
C0603_L1.6-W0.8-H0.8 x 7
SW-SMD_4P-L5.1-W5.1-P3.70-LS6.5-TL_H1.5 x 3
MSOP-8_L3.0-W3.0-P0.65-LS5.0-BL
USB-TYPE-C-SMD_GT-USB-7096C
board_copper
board_pad
board_via
board_PCB
