Cailynoo7/makit-project-4/(list of files, cad)

Other CAD files:
design/radio-reminder/source/assets/5c09d781631f6b1a3ce94d50b9b4fc2dd6d79bd6efb7ce3a07da795ed4948121.step
design/radio-reminder/source/assets/ad33394820d21cf5543f21b62c807454be6d52d688d4a133a56e98dc1e2fe495.step
