Cailynoo7/makit-project-4/(commit log)

2026-11-09 fix(cad): align rear power key and simplify screw seats
    Align the rear power switch with the USB-C port and update the carrier board.
    Remove screw cover wafers and their pockets; use compact countersinks.
    Include the current CAD/PCB source, requirements and matching STEP/fabrication files as the initial hardware baseline.
    Validation: current CAD handoff ready with no interference; PCB fabrication, assembly and mechanical sections ready.
    [15bf1f7de02c94664a699a5cbe4ec2a9611e7452a40138204f7f8616dcfab7d7.step, assembly.step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]
2026-11-09 feat(software): add Android and firmware validation package
    Add the four-button 0.2.0 Android app, XIAO firmware, build scripts and logic tests. Include signed APK, firmware images, source archive, installation and test instructions, validation results and current hardware compatibility metadata. Real-device call, BLE and audio validation remains pending.
2026-11-09 fix(cad): fit rear USB-C opening to socket mouth
    Add a close-fitting outer opening with concealed inner relief, retaining the approximately 19 mm overall thickness. Update enclosure source, fit constraints and assembly/printing guidance with the latest STEP and export record. Static interference and rear-cover removal checks pass; physical plug fit remains for the first prototype.
    [model.step]
2026-11-10 fix(cad): color front triangle red and raise accent dot
    Keep the key cap black and model its red triangle finish. Raise the round decoration by 1.5 mm without changing the enclosure envelope. Include updated requirements, BOM, assembly guidance and the matching STEP handoff. Preserve unrelated software work and staged reference-image deletion.
    [bom.csv, model.step]
2026-11-10 chore: publish to the community
    [5c09d781631f6b1a3ce94d50b9b4fc2dd6d79bd6efb7ce3a07da795ed4948121.step, 69f0ab60741e9760c49b0969f4a014d4314382c1bede449fe0c420f43be73c0c.step, 7c947fffd4b019435b5fcc80e51967e8a3ffbe3208249d547059c1004281f707.step, Android兼容性测试记录.csv, ad33394820d21cf5543f21b62c807454be6d52d688d4a133a56e98dc1e2fe495.step, fcab3e22e1e0827fe7b8ea0bb716072b5507669853ad1d7223d066955ea6e433.step]
2026-11-10 feat(cad): refine rounded handle and enclosure edges
    [bom.csv, model.step]
2026-11-10 fix(cad): include updated enclosure STEP handoff
    [model.step]
